Cocoas-Lab/Robocup-SSL-Circuit/MainBoard/Controller.ods

分類 | 値 | パッケージ | 個数 | 単価 | 小計 | 備考 | URL
IC | LM5160QPWPRQ1 | 14-TSSOP | 1 | 628 | 628 |  | https://www.digikey.jp/product-detail/ja/texas-instruments/LM5160QPWPRQ1/296-42408-1-ND/5358045
IC | MCP1700T-33 | SOT-23 | 1 | 46 | 46 |  | https://www.digikey.jp/product-detail/ja/microchip-technology/MCP1700T-3302E-TT/MCP1700T3302ETTCT-ND/652677
IC | ADR5041 | SC-70 | 1 | 114 | 114 |  | https://www.digikey.jp/product-detail/ja/analog-devices-inc/ADR5041AKSZ-REEL7/ADR5041AKSZ-REEL7CT-ND/3830854
IC | FT232RL | 28-SSOP | 1 | 542 | 542 |  | https://www.digikey.jp/product-detail/ja/ftdi-future-technology-devices-international-ltd/FT232RL-TUBE/768-1306-ND/4006920
IC | LPC1549JBD48 | LQFP48 | 1 | 862 | 862 |  | https://www.digikey.jp/products/ja?keywords=LPC1549JBD48
コネクタ | ディーンズヘッダ |  | 7 |  | 0
コネクタ | 53375-0610 |  | 6 |  | 0
コネクタ | UX60SC-MB-5ST | Micro-B | 1 |  | 0
コネクタ | 53375-0410 |  | 1 |  | 0
コネクタ | 2mmピッチピンヘッダ |  | 2 |  | 0
インダクタ | 22uH |  |  |  | 0
フューズ | 15A |  |  |  | 0
フューズ | 10A |  |  |  | 0
抵抗 |  |  |  |  | 0
抵抗 |  |  |  |  | 0
抵抗 |  |  |  |  | 0
抵抗 |  |  |  |  | 0
抵抗 |  |  |  |  | 0
抵抗 |  |  |  |  | 0
抵抗 |  |  |  |  | 0
抵抗 |  |  |  |  | 0
抵抗 |  |  |  |  | 0
抵抗 |  |  |  |  | 0
セラミックコンデンサ |  |  |  |  | 0
セラミックコンデンサ |  |  |  |  | 0
セラミックコンデンサ |  |  |  |  | 0
セラミックコンデンサ |  |  |  |  | 0
セラミックコンデンサ |  |  |  |  | 0
セラミックコンデンサ |  |  |  |  | 0
セラミックコンデンサ |  |  |  |  | 0
セラミックコンデンサ
セラミックコンデンサ |  |  |  |  | 2192
電解コンデンサ
ダイオード
ダイオード
ダイオード
ダイオード
ダイオード
LED
LED
LED
LED
スイッチ
スイッチ
