Cocoas-Lab/Robocup-SSL-Circuit/KickerBoard/Kicker.ods

Sheet: 単体
名称 | 値 | 形状 | 個数 | 単価 | 小計 | URL
抵抗 | 10 | 1608 | 3 | 12 | 36 | https://www.digikey.jp/product-detail/ja/rohm-semiconductor/ESR03EZPJ102/RHM1.0KDCT-ND/1762924
抵抗 | 100 | 1608 | 1 | 12 | 12 | https://www.digikey.jp/product-detail/ja/yageo/RT0603FRE07100RL/YAG2320CT-ND/5252434
抵抗 | 130k | 1005 | 1 | 9 | 9 | https://www.digikey.jp/product-detail/ja/yageo/RC0402JR-07130KL/YAG3273CT-ND/5282139
抵抗 | 1k | 1005 | 2 | 9 | 18 | https://www.digikey.jp/product-detail/ja/yageo/RC0402JR-071KL/311-1.0KJRCT-ND/729355
抵抗 | 2.2k | 4122 | 1 | 56 | 56 | https://www.digikey.jp/product-detail/ja/te-connectivity-passive-product/SMF32K2JT/A131681CT-ND/8603811
抵抗 | 2.2k | 1005 | 2 | 12 | 24 | https://www.digikey.jp/product-detail/ja/yageo/RC0402FR-072K2L/311-2.20KLRCT-ND/729500
抵抗 | 2.4k | 1005 | 1 | 12 | 12 | https://www.digikey.jp/product-detail/ja/yageo/RC0402JR-072K4L/311-2.4KJRCT-ND/729384
抵抗 | 22 | 1608 | 2 | 12 | 24 | https://www.digikey.jp/product-detail/ja/yageo/RC0603JR-0722RL/311-22GRCT-ND/729690
抵抗 | 2.2 | 1608 | 4 | 12 | 48 | https://www.digikey.jp/product-detail/ja/yageo/RC0603JR-072R2L/311-2.2GRCT-ND/729675
抵抗 | 120k | 1005 | 1 | 9 | 9 | https://www.digikey.jp/product-detail/ja/yageo/RC0402JR-07120KL/311-120KJRCT-ND/729368
抵抗 | 2k | 1005 | 1 | 12 | 12 | https://www.digikey.jp/product-detail/ja/yageo/RC0402FR-072KL/311-2KLRCT-ND/2827883
抵抗 | 2m | R4-FC4L | 1 | 238 | 238 | https://www.digikey.jp/product-detail/ja/ohmite/FC4L64R002GER/FC4L64R002GERCT-ND/3476134
抵抗 | 3.3k | 1005 | 2 | 9 | 18 | https://www.digikey.jp/product-detail/ja/yageo/AC0402FR-073K3L/YAG3483CT-ND/6006332
抵抗 | 330 | 1005 | 4 | 12 | 48 | https://www.digikey.jp/product-detail/ja/yageo/RC0402JR-07330RL/311-330JRCT-ND/729412
抵抗 | 33k | 1005 | 4 | 9 | 36 | https://www.digikey.jp/product-detail/ja/yageo/RC0402JR-0733KL/311-33KJRCT-ND/729415
抵抗 | 10k | 1005 | 18 | 1.7 | 30.6 | https://www.digikey.jp/product-detail/ja/yageo/RC0402JR-0710KL/311-10KJRCT-ND/729365
抵抗 | 0.3m | WSL4026 | 1 | 344 | 344 | https://www.digikey.jp/product-detail/ja/vishay-dale/WSL4026L3000FEB/WSLR-.0003CT-ND/2695229
抵抗 | 1.2M | 1005 | 1 | 12 | 12 | https://www.digikey.jp/product-detail/ja/yageo/RC0402JR-071M2L/YAG3282CT-ND/5282148
抵抗 | 1.5M | 1005 | 1 | 9 | 9 | https://www.digikey.jp/product-detail/ja/yageo/RC0402JR-071M5L/311-1.5MJRCT-ND/729360
抵抗 | 750 | 1005 | 1 | 12 | 12 | https://www.digikey.jp/product-detail/ja/yageo/RC0402FR-07750RL/311-750LRCT-ND/2827891
アルミ電解コンデンサ | 220u | D=6.30[mm] | 1 | 101 | 101 | https://www.digikey.jp/product-detail/ja/nichicon/UCV1V221MCL1GS/493-14355-1-ND/5724342
積層セラミックコンデンサ | 0.1u | 1005 | 10 | 11.9 | 119 | https://www.digikey.jp/product-detail/ja/taiyo-yuden/GMK105BJ104KV-F/587-1994-6-ND/1646692
積層セラミックコンデンサ | 0.22u | 1005 | 2 | 12 | 24 | https://www.digikey.jp/product-detail/ja/samsung-electro-mechanics/CL05F224ZO5NNNC/1276-1060-1-ND/3889146
積層セラミックコンデンサ | 0.47n | 1005 | 2 | 12 | 24 | https://www.digikey.jp/product-detail/ja/tdk-corporation/CGA2B2C0G1H471J050BA/445-5604-1-ND/2443644
積層セラミックコンデンサ | 10n | 1005 | 3 | 12 | 36 | https://www.digikey.jp/product-detail/ja/murata-electronics-north-america/GCM155R71H103KA55D/490-4762-1-ND/1641681
積層セラミックコンデンサ | 10p | 1005 | 2 | 12 | 24 | https://www.digikey.jp/product-detail/ja/murata-electronics-north-america/GRM1555C1H100GA01D/490-6187-1-ND/3845387
積層セラミックコンデンサ | 22n | 1005 | 1 | 14 | 14 | https://www.digikey.jp/product-detail/ja/tdk-corporation/CGA2B3X5R1H223M050BB/445-12206-1-ND/3953872
積層セラミックコンデンサ | 4.7u | 1608 | 2 | 50 | 100 | https://www.digikey.jp/product-detail/ja/samsung-electro-mechanics/CL10A475KL8NRNC/1276-6794-1-ND/5961653
積層セラミックコンデンサ | 47n | 3216 | 1 | 42 | 42 | https://www.digikey.jp/product-detail/ja/murata-electronics-north-america/GRM31CR72H473KW09L/490-16312-1-ND/7363294
インダクタ | 15u | 4949 | 1 | 70 | 70 | https://www.digikey.jp/product-detail/ja/taiyo-yuden/NRS5040T150MMGJV/587-6108-1-ND/8573098
インダクタ | 8.2u | 6664 | 1 | 190 | 190 | https://www.digikey.jp/product-detail/ja/bourns-inc/SRP6060FA-8R2M/SRP6060FA-8R2MCT-ND/9351142
フューズ | 15A | 3216 | 1 | 114 | 114 | https://www.digikey.jp/product-detail/ja/littelfuse-inc/0501015.WR/F2919CT-ND/1953081
IC | AD8601 | SOT23-5 | 1 | 138 | 138 | https://www.digikey.jp/product-detail/ja/analog-devices-inc/AD8601WDRTZ-REEL7/AD8601WDRTZ-REEL7CT-ND/2237758
IC | ADCMP350YKSZ | KS_4 | 1 | 129 | 129 | https://www.digikey.jp/product-detail/ja/analog-devices-inc/ADCMP350YKSZ-REEL7/ADCMP350YKSZ-REEL7CT-ND/2467894
IC | ADR5041 | SC70-3 | 1 | 113 | 113 | https://www.digikey.jp/product-detail/ja/analog-devices-inc/ADR5041AKSZ-REEL7/ADR5041AKSZ-REEL7CT-ND/3830854
IC | INA213 | SC70-6 | 1 | 178 | 178 | https://www.digikey.jp/product-detail/ja/texas-instruments/INA213AIDCKR/296-26072-1-ND/2254845
IC | MAX3051ESA+ | SOIC127P600X175-8N | 1 | 391 | 391 | https://www.digikey.jp/product-detail/ja/maxim-integrated/MAX3051ESA-T/MAX3051ESA-CT-ND/5402433
IC | MIC5219-3.3YMM | MSOP-8_MM | 1 | 141 | 141 | https://www.digikey.jp/product-detail/ja/microchip-technology/MIC5219-3.3YMM-TR/MIC5219-3.3YMM-CT-ND/9450540
IC | LT6108-2 | MSOP8 | 1 | 385 | 385 | https://www.digikey.jp/product-detail/ja/linear-technology-analog-devices/LT6108IMS8-2-PBF/LT6108IMS8-2-PBF-ND/2734947
IC | LM5160QPWPRQ1 | SOP65P640X110-15N | 1 | 605 | 605 | https://www.digikey.jp/product-detail/ja/texas-instruments/LM5160QPWPRQ1/296-42408-1-ND/5358045
IC | LPC1549JBD48 | QFP48 | 1 | 864 | 864 | https://www.digikey.jp/products/ja?keywords=LPC1549JBD48
IC | TPD4S014DSQR |  | 1 | 205 | 205 | https://www.digikey.jp/product-detail/ja/texas-instruments/TPD4S014DSQR/296-29093-1-ND/2688396
IC | UCC27212DPRT |  | 1 | 491 | 491 | https://www.digikey.jp/product-detail/ja/texas-instruments/UCC27212DPRT/296-47091-1-ND/7596472
IC | UCC27512DRSR |  | 1 | 173 | 173 | https://www.digikey.jp/product-detail/ja/texas-instruments/UCC27512DRSR/296-34812-1-ND/3523717
IC | UCC27524DGN-NOPAD |  | 1 | 206 | 206 | https://www.digikey.jp/product-detail/ja/texas-instruments/UCC27524DGNR/296-30607-1-ND/3486672
IGBT | IXXH80N65B4 | TO247-3 | 2 | 803 | 1606 | https://www.digikey.jp/product-detail/ja/ixys/IXXH80N65B4/IXXH80N65B4-ND/3908803
FET | AO4444 | SOIC8 | 2 | 211 | 422 | https://www.digikey.jp/product-detail/ja/vishay-siliconix/SI4090DY-T1-GE3/SI4090DY-T1-GE3CT-ND/3458171
FET | BSP130 | SOT23-3 | 1 | 102 | 102 | https://www.digikey.jp/product-detail/ja/nexperia-usa-inc/BSP130115/1727-4928-1-ND/2531507
FET | BSS138 | SOT23-3 | 1 | 38 | 38 | https://www.digikey.jp/product-detail/ja/on-semiconductor/BSS138/BSS138CT-ND/244294
FET | TK12P60W | DPAK-3 | 1 | 385 | 385 | https://www.digikey.jp/product-detail/ja/infineon-technologies/IPD80R280P7ATMA1/IPD80R280P7ATMA1CT-ND/6228209
Transistor | ZXTN08400BFF | SOT23-3 | 1 | 40 | 40 | https://www.digikey.jp/product-detail/ja/on-semiconductor/FJV42MTF/FJV42MTFCT-ND/4553174
ダイオード | US5G-TP | DO214-AB | 1 | 66 | 66 | https://www.digikey.jp/product-detail/ja/micro-commercial-co/US5G-TP/US5G-TPMSCT-ND/8554572
ダイオード | SMAJ300 | DO-214AC | 1 | 68 | 68 | https://www.digikey.jp/product-detail/ja/littelfuse-inc/SMAJ300A/SMAJ300ALFCT-ND/762560
ダイオード | SMAJP4KE30A | DO-214AC | 1 | 60 | 60 | https://www.digikey.jp/product-detail/ja/micro-commercial-co/SMAJP4KE30A-TP/SMAJP4KE30A-TPMSCT-ND/7681713
ダイオード | AS4PG | SMPC | 2 | 89 | 178 | https://www.digikey.jp/product-detail/ja/vishay-semiconductor-diodes-division/AS4PG-M3-86A/AS4PG-M3-86AGICT-ND/2709013
ダイオード | SDM2U40CSP | WLB1608 | 2 | 55 | 110 | https://www.digikey.jp/product-detail/ja/diodes-incorporated/SDM2U40CSP-7B/SDM2U40CSP-7BDICT-ND/6013037
ダイオード | RB520S | SOD523 | 5 | 20.4 | 102 | https://www.digikey.jp/product-detail/ja/on-semiconductor/RB520S30T1G/RB520S30T1GOSCT-ND/964626
LED | 赤 | 1608 | 3 |  | 0
LED | 緑 | 1608 | 1 |  | 0
LED | 白 | 1608 | 1 |  | 0
発振子 | FA238V |  | 1 | 135 | 135 | https://www.digikey.jp/product-detail/ja/epson/FA-238V-12.0000MB-K3/SER3682CT-ND/2403455
コネクタ | 5569-02A2 |  | 2 | 128 | 256 | https://www.digikey.jp/products/ja?keywords=39-30-1021
コネクタ | SM03B-ZESS-TB |  | 1 | 77 | 77 | https://www.digikey.jp/product-detail/ja/jst-sales-america-inc/SM03B-ZESS-TB-LF-SN/455-2396-1-ND/1887049
コネクタ | Micro USB |  | 1 | 98 | 98 | https://www.digikey.jp/product-detail/ja/hirose-electric-co-ltd/ZX62-AB-5PA-31/H125279CT-ND/5994741
スイッチ | SKRP |  | 2 |  | 0
合計 |  |  |  |  | 9627.6

Sheet: 10枚製作時
名称 | 値 | 形状 | 個数 | 単価 | 小計 | URL
抵抗 | 10 | 1608 | 30 | 10.3 | 309 | https://www.digikey.jp/product-detail/ja/rohm-semiconductor/ESR03EZPJ102/RHM1.0KDCT-ND/1762924
抵抗 | 100 | 1608 | 10 | 8.1 | 81 | https://www.digikey.jp/product-detail/ja/yageo/RT0603FRE07100RL/YAG2320CT-ND/5252434
抵抗 | 130k | 1005 | 10 | 1.7 | 17 | https://www.digikey.jp/product-detail/ja/yageo/RC0402JR-07130KL/YAG3273CT-ND/5282139
抵抗 | 1k | 1005 | 20 | 1.7 | 34 | https://www.digikey.jp/product-detail/ja/yageo/RC0402JR-071KL/311-1.0KJRCT-ND/729355
抵抗 | 2.2k | R-S-3 | 10 | 46.7 | 467 | https://www.digikey.jp/product-detail/ja/te-connectivity-passive-product/SMF32K2JT/A131681CT-ND/8603811
抵抗 | 2.2k | 1005 | 20 | 2.1 | 42 | https://www.digikey.jp/product-detail/ja/yageo/RC0402FR-072K2L/311-2.20KLRCT-ND/729500
抵抗 | 2.4k | 1005 | 10 | 1.8 | 18 | https://www.digikey.jp/product-detail/ja/yageo/RC0402JR-072K4L/311-2.4KJRCT-ND/729384
抵抗 | 22 | 1608 | 20 | 2.6 | 52 | https://www.digikey.jp/product-detail/ja/yageo/RC0603JR-0722RL/311-22GRCT-ND/729690
抵抗 | 2.2 | 1608 | 40 | 5.2 | 208 | https://www.digikey.jp/product-detail/ja/yageo/RC0603JR-072R2L/311-2.2GRCT-ND/729675
抵抗 | 120k | 1005 | 10 | 1.7 | 17 | https://www.digikey.jp/product-detail/ja/yageo/RC0402JR-07120KL/311-120KJRCT-ND/729368
抵抗 | 2k | 1005 | 10 | 2.1 | 21 | https://www.digikey.jp/product-detail/ja/yageo/RC0402FR-072KL/311-2KLRCT-ND/2827883
抵抗 | 2m | R4-FC4L | 10 | 210.9 | 2109 | https://www.digikey.jp/product-detail/ja/ohmite/FC4L64R002GER/FC4L64R002GERCT-ND/3476134
抵抗 | 3.3k | 1005 | 20 | 2.8 | 56 | https://www.digikey.jp/product-detail/ja/yageo/AC0402FR-073K3L/YAG3483CT-ND/6006332
抵抗 | 330 | 1005 | 40 | 1.8 | 72 | https://www.digikey.jp/product-detail/ja/yageo/RC0402JR-07330RL/311-330JRCT-ND/729412
抵抗 | 33k | 1005 | 40 | 1.7 | 68 | https://www.digikey.jp/product-detail/ja/yageo/RC0402JR-0733KL/311-33KJRCT-ND/729415
抵抗 | 10k | 1005 | 180 | 0.69 | 124.2 | https://www.digikey.jp/product-detail/ja/yageo/RC0402JR-0710KL/311-10KJRCT-ND/729365
抵抗 | 0.3m | WSL4026 | 10 | 305.1 | 3051 | https://www.digikey.jp/product-detail/ja/vishay-dale/WSL4026L3000FEB/WSLR-.0003CT-ND/2695229
抵抗 | 1.2M | 1005 | 10 | 1.8 | 18 | https://www.digikey.jp/product-detail/ja/yageo/RC0402JR-071M2L/YAG3282CT-ND/5282148
抵抗 | 1.5M | 1005 | 10 | 1.7 | 17 | https://www.digikey.jp/product-detail/ja/yageo/RC0402JR-071M5L/311-1.5MJRCT-ND/729360
抵抗 | 750 | 1005 | 10 | 2.1 | 21 | https://www.digikey.jp/product-detail/ja/yageo/RC0402FR-07750RL/311-750LRCT-ND/2827891
アルミ電解コンデンサ | 22u | D=6.30[mm] | 10 | 76.4 | 764 | https://www.digikey.jp/product-detail/ja/nichicon/UCV1V221MCL1GS/493-14355-1-ND/5724342
積層セラミックコンデンサ | 0.1u | 1005 | 100 | 5.56 | 556 | https://www.digikey.jp/product-detail/ja/taiyo-yuden/GMK105BJ104KV-F/587-1994-6-ND/1646692
積層セラミックコンデンサ | 0.22u | 1005 | 20 | 7.8 | 156 | https://www.digikey.jp/product-detail/ja/samsung-electro-mechanics/CL05F224ZO5NNNC/1276-1060-1-ND/3889146
積層セラミックコンデンサ | 0.47n | 1005 | 20 | 8.1 | 162 | https://www.digikey.jp/product-detail/ja/tdk-corporation/CGA2B2C0G1H471J050BA/445-5604-1-ND/2443644
積層セラミックコンデンサ | 10n | 1005 | 30 | 5.7 | 171 | https://www.digikey.jp/product-detail/ja/murata-electronics-north-america/GCM155R71H103KA55D/490-4762-1-ND/1641681
積層セラミックコンデンサ | 10p | 1005 | 20 | 9 | 180 | https://www.digikey.jp/product-detail/ja/murata-electronics-north-america/GRM1555C1H100GA01D/490-6187-1-ND/3845387
積層セラミックコンデンサ | 22n | 1005 | 10 | 10.8 | 108 | https://www.digikey.jp/product-detail/ja/tdk-corporation/CGA2B3X5R1H223M050BB/445-12206-1-ND/3953872
積層セラミックコンデンサ | 4.7u | 1608 | 20 | 34.9 | 698 | https://www.digikey.jp/product-detail/ja/samsung-electro-mechanics/CL10A475KL8NRNC/1276-6794-1-ND/5961653
積層セラミックコンデンサ | 47n | 3216 | 10 | 28.5 | 285 | https://www.digikey.jp/product-detail/ja/murata-electronics-north-america/GRM31CR72H473KW09L/490-16312-1-ND/7363294
インダクタ | 15u | 4949 | 10 | 60.8 | 608 | https://www.digikey.jp/product-detail/ja/taiyo-yuden/NRS5040T150MMGJV/587-6108-1-ND/8573098
インダクタ | 8.2u | 6664 | 10 | 174.9 | 1749 | https://www.digikey.jp/product-detail/ja/bourns-inc/SRP6060FA-8R2M/SRP6060FA-8R2MCT-ND/9351142
フューズ | 15A | 3216 | 10 | 103.3 | 1033 | https://www.digikey.jp/product-detail/ja/littelfuse-inc/0501015.WR/F2919CT-ND/1953081
IC | AD8601 | SOT23-5 | 10 | 122.5 | 1225 | https://www.digikey.jp/product-detail/ja/analog-devices-inc/AD8601WDRTZ-REEL7/AD8601WDRTZ-REEL7CT-ND/2237758
IC | ADCMP350YKSZ | KS_4 | 10 | 115.3 | 1153 | https://www.digikey.jp/product-detail/ja/analog-devices-inc/ADCMP350YKSZ-REEL7/ADCMP350YKSZ-REEL7CT-ND/2467894
IC | ADR5041 | SC70-3 | 10 | 100.9 | 1009 | https://www.digikey.jp/product-detail/ja/analog-devices-inc/ADR5041AKSZ-REEL7/ADR5041AKSZ-REEL7CT-ND/3830854
IC | INA213 | SC70-6 | 10 | 158.5 | 1585 | https://www.digikey.jp/product-detail/ja/texas-instruments/INA213AIDCKR/296-26072-1-ND/2254845
IC | MAX3051ESA+ | SOIC127P600X175-8N | 10 | 368.9 | 3689 | https://www.digikey.jp/product-detail/ja/maxim-integrated/MAX3051ESA-T/MAX3051ESA-CT-ND/5402433
IC | MIC5219-3.3YMM | MSOP-8_MM | 10 | 141 | 1410 | https://www.digikey.jp/product-detail/ja/microchip-technology/MIC5219-3.3YMM-TR/MIC5219-3.3YMM-CT-ND/9450540
IC | LT6108-2 | MSOP8 | 10 | 385 | 3850 | https://www.digikey.jp/product-detail/ja/linear-technology-analog-devices/LT6108IMS8-2-PBF/LT6108IMS8-2-PBF-ND/2734947
IC | LM5160QPWPRQ1 | SOP65P640X110-15N | 10 | 543.3 | 5433 | https://www.digikey.jp/product-detail/ja/texas-instruments/LM5160QPWPRQ1/296-42408-1-ND/5358045
IC | LPC1549JBD48 | QFP48 | 10 | 780.8 | 7808 | https://www.digikey.jp/products/ja?keywords=LPC1549JBD48
IC | TPD4S014DSQR |  | 10 | 183.1 | 1831 | https://www.digikey.jp/product-detail/ja/texas-instruments/TPD4S014DSQR/296-29093-1-ND/2688396
IC | UCC27212DPRT |  | 10 | 441.2 | 4412 | https://www.digikey.jp/product-detail/ja/texas-instruments/UCC27212DPRT/296-47091-1-ND/7596472
IC | UCC27512DRSR |  | 10 | 155.3 | 1553 | https://www.digikey.jp/product-detail/ja/texas-instruments/UCC27512DRSR/296-34812-1-ND/3523717
IC | UCC27524DGN-NOPAD |  | 10 | 185.1 | 1851 | https://www.digikey.jp/product-detail/ja/texas-instruments/UCC27524DGNR/296-30607-1-ND/3486672
IGBT | IXXH80N65B4 | TO247-3 | 20 | 772.7 | 15454 | https://www.digikey.jp/product-detail/ja/ixys/IXXH80N65B4/IXXH80N65B4-ND/3908803
FET | AO4444 | SOIC8 | 20 | 187.2 | 3744 | https://www.digikey.jp/product-detail/ja/vishay-siliconix/SI4090DY-T1-GE3/SI4090DY-T1-GE3CT-ND/3458171
FET | BSP130 | SOT23-3 | 10 | 90.2 | 902 | https://www.digikey.jp/product-detail/ja/nexperia-usa-inc/BSP130115/1727-4928-1-ND/2531507
FET | BSS138 | SOT23-3 | 10 | 34.6 | 346 | https://www.digikey.jp/product-detail/ja/on-semiconductor/BSS138/BSS138CT-ND/244294
FET | TK12P60W | DPAK-3 | 10 | 334.3 | 3343 | https://www.digikey.jp/product-detail/ja/infineon-technologies/IPD80R280P7ATMA1/IPD80R280P7ATMA1CT-ND/6228209
Transistor | ZXTN08400BFF | SOT23-3 | 10 | 30.4 | 304 | https://www.digikey.jp/product-detail/ja/on-semiconductor/FJV42MTF/FJV42MTFCT-ND/4553174
ダイオード | US5G-TP | DO214-AB | 10 | 52.3 | 523 | https://www.digikey.jp/product-detail/ja/micro-commercial-co/US5G-TP/US5G-TPMSCT-ND/8554572
ダイオード | SMAJ300 | DO-214AC | 10 | 56.9 | 569 | https://www.digikey.jp/product-detail/ja/littelfuse-inc/SMAJ300A/SMAJ300ALFCT-ND/762560
ダイオード | SMAJP4KE30A | DO-214AC | 10 | 42.9 | 429 | https://www.digikey.jp/product-detail/ja/micro-commercial-co/SMAJP4KE30A-TP/SMAJP4KE30A-TPMSCT-ND/7681713
ダイオード | AS4PG | SMPC | 20 | 77.9 | 1558 | https://www.digikey.jp/product-detail/ja/vishay-semiconductor-diodes-division/AS4PG-M3-86A/AS4PG-M3-86AGICT-ND/2709013
ダイオード | SDM2U40CSP | WLB1608 | 20 | 41 | 820 | https://www.digikey.jp/product-detail/ja/diodes-incorporated/SDM2U40CSP-7B/SDM2U40CSP-7BDICT-ND/6013037
ダイオード | RB520S | SOD523 | 50 | 20.4 | 1020 | https://www.digikey.jp/product-detail/ja/on-semiconductor/RB520S30T1G/RB520S30T1GOSCT-ND/964626
LED | 赤 | 1608 | 30 |  | 0
LED | 緑 | 1608 | 10 |  | 0
LED | 白 | 1608 | 10 | 0 | 0
発振子 | FA238V |  | 10 | 120 | 1200 | https://www.digikey.jp/product-detail/ja/epson/FA-238V-12.0000MB-K3/SER3682CT-ND/2403455
コネクタ | 5569-02A2 |  | 20 | 112.9 | 2258 | https://www.digikey.jp/products/ja?keywords=39-30-1021
コネクタ | SM03B-ZESS-TB |  | 10 | 72 | 720 | https://www.digikey.jp/product-detail/ja/jst-sales-america-inc/SM03B-ZESS-TB-LF-SN/455-2396-1-ND/1887049
コネクタ | Micro USB |  | 10 | 86.4 | 864 | https://www.digikey.jp/product-detail/ja/hirose-electric-co-ltd/ZX62-AB-5PA-31/H125279CT-ND/5994741
スイッチ | SKRP |  | 20 |  | 0
合計 |  |  |  |  | 84135.2
基板単価 |  |  |  |  | 8413.52
