Cocoas-Lab/Robocup-SSL-Circuit/MotorDriver/MotorDriver.ods

Sheet: 単体
分類 | 値 | パッケージ | 個数 | 単価 | 小計 | 備考 | URL
IC | LPC1549JBD48 | LQFP48 | 1 | 862 | 862 |  | https://www.digikey.jp/products/ja?keywords=LPC1549JBD48
IC | DRV8320SRTVT | WQFN32 | 1 | 482 | 482 |  | https://www.digikey.jp/product-detail/ja/texas-instruments/DRV8320SRTVT/296-47007-1-ND/7427014
IC | MCP1700T-33 | SOT-23 | 1 | 46 | 46 |  | https://www.digikey.jp/product-detail/ja/microchip-technology/MCP1700T-3302E-TT/MCP1700T3302ETTCT-ND/652677
IC | ADR5041 | SC-70 | 1 | 114 | 114 |  | https://www.digikey.jp/product-detail/ja/analog-devices-inc/ADR5041AKSZ-REEL7/ADR5041AKSZ-REEL7CT-ND/3830854
IC | ADCMP350 | SC-70 | 1 | 128 | 128 |  | https://www.digikey.jp/product-detail/ja/analog-devices-inc/ADCMP350YKSZ-REEL7/ADCMP350YKSZ-REEL7CT-ND/2467894
IC | MAX3051ESA | SOIC-8 | 1 | 389 | 389 |  | https://www.digikey.jp/product-detail/ja/maxim-integrated/MAX3051ESA-T/MAX3051ESA-CT-ND/5402433
IC | TPD4S014DSQR | WFDFN-10 | 1 | 204 | 204 |  | https://www.digikey.jp/product-detail/ja/texas-instruments/TPD4S014DSQR/296-29093-1-ND/2688396
IC | AS5601 | SOIC-8 | 1 | 615 | 615 |  | https://www.digikey.jp/product-detail/ja/ams/AS5601-ASOM/AS5601-ASOMCT-ND/5032390
抵抗 | 10 | 1608 | 6 | 12 | 72 |  | https://www.digikey.jp/product-detail/ja/rohm-semiconductor/ESR03EZPJ102/RHM1.0KDCT-ND/1762924
抵抗 | 330 | 1005 | 5 | 12 | 60 |  | https://www.digikey.jp/product-detail/ja/yageo/RC0603FR-07100RL/311-330HRCT-ND/
抵抗 | 2.2k | 1005 | 6 |  | 0 |  | https://www.digikey.jp/product-detail/ja/te-connectivity-passive-product/CRGCQ0402J2K2/A130050CT-ND/8577882
抵抗 | 10k | 1005 | 5 | 12 | 60 |  | https://www.digikey.jp/product-detail/ja/yageo/RC0603JR-0710KL/311-10KGRCT-ND/729647
抵抗 | 12k | 1005 | 1 |  | 0 |  | https://www.digikey.jp/product-detail/ja/stackpole-electronics-inc/RMCF0402JT12K0/RMCF0402JT12K0CT-ND/2417827
抵抗 | 22k | 1005 | 1 |  | 0 |  | https://www.digikey.jp/product-detail/ja/te-connectivity-passive-product/CRGCQ0402J22K/A130056CT-ND/8577888
抵抗 | 33k | 1005 | 1 |  | 0 |  | https://www.digikey.jp/product-detail/ja/te-connectivity-passive-product/CRGCQ0402J33K/A130057CT-ND/8577889
抵抗 | 100k | 1005 | 1 |  | 0 |  | https://www.digikey.jp/product-detail/ja/te-connectivity-passive-product/CRGCQ0402J100K/A130060CT-ND/8577892
セラミックコンデンサ | 10p | 1005 | 2 |  | 0 |  | https://www.digikey.jp/product-detail/ja/kemet/C0402C100K5GACTU/399-7747-1-ND/3471470
セラミックコンデンサ | 47n | 1005 | 3 | 12 | 36 |  | https://www.digikey.jp/product-detail/ja/yageo/CC0402KRX7R9BB473/311-3815-1-ND/8024904
セラミックコンデンサ | 0.1u | 1005 | 8 | 17 | 136 |  | https://www.digikey.jp/product-detail/ja/tdk-corporation/CGA3E3X7S2A104K080AB/445-6938-1-ND/2672956
セラミックコンデンサ | 1u | 1005 | 2 | 56 | 112 |  | https://www.digikey.jp/product-detail/ja/tdk-corporation/CGB2A1JB1E105M033BC/445-12016-1-ND/3953682
セラミックコンデンサ | 10u | 3225 | 13 | 83 | 1079 | 将来的に22[uF]。 実装数を減らしてもいいかも | https://www.digikey.jp/product-detail/ja/kemet/C1210C106M6PACTU/399-5509-1-ND/1950687
インダクタ | 33u | 5050 | 1 |  |  |  | https://www.digikey.jp/product-detail/ja/taiyo-yuden/NR5040T330M/587-2370-1-ND/2178983
ヒューズ | 20A | 3216 | 1 | 145 |  |  | https://www.digikey.jp/product-detail/ja/eaton/TR-3216FF20-R/283-2794-1-ND/1473436
発振子 | 12MHz | SMD | 1 |  |  |  | https://www.digikey.jp/product-detail/ja/epson/FA-238V-12.0000MB-K3/SER3682CT-ND/2403455
FET | BUK7Y3R5-40E | SOT-669 | 6 | 125 | 750 |  | https://www.digikey.jp/product-detail/ja/nexperia-usa-inc/BUK7Y3R5-40HX/1727-7477-1-ND/7897323
ダイオード | SK34ATR | DO-214AC | 6 | 55 | 330 | フリーホイール。 FETのボディダイオードだけでいいかも？ | https://www.digikey.jp/product-detail/ja/smc-diode-solutions/SK34ATR/1655-1591-1-ND/6023036
ダイオード | RB520S30T1G | SOD-523 | 3 | 25 | 75 |  | https://www.digikey.jp/product-detail/ja/on-semiconductor/RB520S30T1G/RB520S30T1GOSCT-ND/964626
ダイオード | SDM2U40CSP |  | 3 |  |  |  | https://www.digikey.jp/product-detail/ja/diodes-incorporated/SDM2U40CSP-7B/SDM2U40CSP-7BDICT-ND/6013037
ダイオード | SMAJP4KE30A | DO-214AC | 1 |  |  |  | https://www.digikey.jp/product-detail/ja/micro-commercial-co/SMAJP4KE30A-TP/SMAJP4KE30A-TPMSCT-ND/7681713
ダイオード | TSPB20U80S S1G | TO-277 | 1 |  |  |  | https://www.digikey.jp/product-detail/ja/taiwan-semiconductor-corporation/TSPB20U80S-S1G/TSPB20U80SS1GCT-ND/7360696
LED | 赤 | 1608 | 3 | 45 | 135 |  | https://www.digikey.jp/product-detail/ja/osram-opto-semiconductors-inc/LS-Q976-NR-1/475-2512-1-ND/1802639
LED | 白 | 1608 | 1 | 58 | 58 |  | https://www.digikey.jp/product-detail/ja/osram-opto-semiconductors-inc/LW-Q38E-Q1OO-3K6L-1/475-2831-1-ND/2176369
LED | 青 | 1608 | 1 | 58 | 58 |  | https://www.digikey.jp/product-detail/ja/osram-opto-semiconductors-inc/LB-Q39G-L2OO-35-1/475-2816-1-ND/2176355
コネクタ | SM03B-ZESS-TB(LF)(SN) |  | 1 | 77 | 77 |  | https://www.digikey.jp/product-detail/ja/jst-sales-america-inc/SM03B-ZESS-TB-LF-SN/455-2396-1-ND/1887049
コネクタ | 43045-0800 |  | 1 | 247 | 247 |  | https://www.digikey.jp/products/ja?keywords=43045-0800
コネクタ | USB-micro typeB |  | 1 |  |  |  | https://www.digikey.jp/product-detail/ja/hirose-electric-co-ltd/ZX62-AB-5PA-31/H125279CT-ND/5994741
コネクタ | XT60 |  | 1 |  |  | どこで買おう 横付けのタイプがあればうれしい
スイッチ | SKRPACE010 |  | 2 | 20 | 40 | 5個で100円のパック | http://akizukidenshi.com/catalog/g/gP-06185/
合計 |  |  |  |  | 6165

Sheet: 20枚製作時
分類 | 値 | パッケージ | 個数 | 単価 | 小計 | 備考 | URL
IC | LPC1549JBD48 | LQFP48 | 20 | 775.9 | 15518 |  | https://www.digikey.jp/products/ja?keywords=LPC1549JBD48
IC | DRV8320SRTVT | WQFN32 | 20 | 430.7 | 8614 |  | https://www.digikey.jp/product-detail/ja/texas-instruments/DRV8320SRTVT/296-47007-1-ND/7427014
IC | MCP1700T-33 | SOT-23 | 20 | 37.6 | 752 |  | https://www.digikey.jp/product-detail/ja/microchip-technology/MCP1700T-3302E-TT/MCP1700T3302ETTCT-ND/652677
IC | ADR5041 | SC-70 | 20 | 100.3 | 2006 |  | https://www.digikey.jp/product-detail/ja/analog-devices-inc/ADR5041AKSZ-REEL7/ADR5041AKSZ-REEL7CT-ND/3830854
IC | ADCMP350 | SC-70 | 20 | 114.5 | 2290 |  | https://www.digikey.jp/product-detail/ja/analog-devices-inc/ADCMP350YKSZ-REEL7/ADCMP350YKSZ-REEL7CT-ND/2467894
IC | MAX3051ESA | SOIC-8 | 20 | 366.6 | 7332 |  | https://www.digikey.jp/product-detail/ja/maxim-integrated/MAX3051ESA-T/MAX3051ESA-CT-ND/5402433
IC | TPD4S014DSQR | WFDFN-10 | 20 | 181.9 | 3638 |  | https://www.digikey.jp/product-detail/ja/texas-instruments/TPD4S014DSQR/296-29093-1-ND/2688396
IC | AS5601 | SOIC-8 | 20 | 479.8 | 9596 |  | https://www.digikey.jp/product-detail/ja/ams/AS5601-ASOM/AS5601-ASOMCT-ND/5032390
抵抗 | 10 | 1608 | 120 | 3.92 | 470.4 |  | https://www.digikey.jp/product-detail/ja/rohm-semiconductor/ESR03EZPJ102/RHM1.0KDCT-ND/1762924
抵抗 | 330 | 1005 | 100 | 1.26 | 126 |  | https://www.digikey.jp/product-detail/ja/yageo/RC0603FR-07100RL/311-330HRCT-ND/
抵抗 | 2.2k | 1005 | 120 | 0.51 | 61.2 |  | https://www.digikey.jp/product-detail/ja/te-connectivity-passive-product/CRGCQ0402J2K2/A130050CT-ND/8577882
抵抗 | 10k | 1005 | 100 | 1.04 | 104 |  | https://www.digikey.jp/product-detail/ja/yageo/RC0603JR-0710KL/311-10KGRCT-ND/729647
抵抗 | 12k | 1005 | 20 | 1.5 | 30 |  | https://www.digikey.jp/product-detail/ja/stackpole-electronics-inc/RMCF0402JT12K0/RMCF0402JT12K0CT-ND/2417827
抵抗 | 22k | 1005 | 20 | 1.3 | 26 |  | https://www.digikey.jp/product-detail/ja/te-connectivity-passive-product/CRGCQ0402J22K/A130056CT-ND/8577888
抵抗 | 33k | 1005 | 20 | 1.3 | 26 |  | https://www.digikey.jp/product-detail/ja/te-connectivity-passive-product/CRGCQ0402J33K/A130057CT-ND/8577889
抵抗 | 100k | 1005 | 20 | 1.3 | 26 |  | https://www.digikey.jp/product-detail/ja/te-connectivity-passive-product/CRGCQ0402J100K/A130060CT-ND/8577892
セラミックコンデンサ | 10p | 1005 | 40 | 2.5 | 100 |  | https://www.digikey.jp/product-detail/ja/kemet/C0402C100K5GACTU/399-7747-1-ND/3471470
セラミックコンデンサ | 47n | 1005 | 60 | 9 | 540 |  | https://www.digikey.jp/product-detail/ja/yageo/CC0402KRX7R9BB473/311-3815-1-ND/8024904
セラミックコンデンサ | 0.1u | 1005 | 160 | 9.27 | 1483.2 |  | https://www.digikey.jp/product-detail/ja/tdk-corporation/CGA3E3X7S2A104K080AB/445-6938-1-ND/2672956
セラミックコンデンサ | 1u | 1005 | 40 | 20.4 | 816 |  | https://www.digikey.jp/product-detail/ja/tdk-corporation/CGB2A1JB1E105M033BC/445-12016-1-ND/3953682
セラミックコンデンサ | 10u | 3225 | 260 | 56.91 | 14796.6 | 将来的に22[uF]。 実装数を減らしてもいいかも | https://www.digikey.jp/product-detail/ja/kemet/C1210C106M6PACTU/399-5509-1-ND/1950687
インダクタ | 33u | 5050 | 20 | 46 | 920 |  | https://www.digikey.jp/product-detail/ja/taiyo-yuden/NR5040T330M/587-2370-1-ND/2178983
ヒューズ | 20A | 3216 | 20 | 131 | 2620 |  | https://www.digikey.jp/product-detail/ja/eaton/TR-3216FF20-R/283-2794-1-ND/1473436
発振子 | 12MHz | SMD | 20 | 119.2 | 2384 |  | https://www.digikey.jp/product-detail/ja/epson/FA-238V-12.0000MB-K3/SER3682CT-ND/2403455
FET | BUK7Y3R5-40E | SOT-669 | 120 | 91.31 | 10957.2 |  | https://www.digikey.jp/product-detail/ja/nexperia-usa-inc/BUK7Y3R5-40HX/1727-7477-1-ND/7897323
ダイオード | SK34ATR | DO-214AC | 120 | 23.44 | 2812.8 | フリーホイール。 FETのボディダイオードだけでいいかも？ | https://www.digikey.jp/product-detail/ja/smc-diode-solutions/SK34ATR/1655-1591-1-ND/6023036
ダイオード | RB520S30T1G | SOD-523 | 60 | 20.3 | 1218 |  | https://www.digikey.jp/product-detail/ja/on-semiconductor/RB520S30T1G/RB520S30T1GOSCT-ND/964626
ダイオード | SDM2U40CSP |  | 60 | 40.8 | 2448 |  | https://www.digikey.jp/product-detail/ja/diodes-incorporated/SDM2U40CSP-7B/SDM2U40CSP-7BDICT-ND/6013037
ダイオード | SMAJP4KE30A | DO-214AC | 20 | 42.7 | 854 |  | https://www.digikey.jp/product-detail/ja/micro-commercial-co/SMAJP4KE30A-TP/SMAJP4KE30A-TPMSCT-ND/7681713
ダイオード | TSPB20U80S S1G | TO-277 | 20 | 110.6 | 2212 |  | https://www.digikey.jp/product-detail/ja/taiwan-semiconductor-corporation/TSPB20U80S-S1G/TSPB20U80SS1GCT-ND/7360696
LED | 赤 | 1608 | 60 | 23.8 | 1428 |  | https://www.digikey.jp/product-detail/ja/osram-opto-semiconductors-inc/LS-Q976-NR-1/475-2512-1-ND/1802639
LED | 白 | 1608 | 20 | 41.7 | 834 |  | https://www.digikey.jp/product-detail/ja/osram-opto-semiconductors-inc/LW-Q38E-Q1OO-3K6L-1/475-2831-1-ND/2176369
LED | 青 | 1608 | 20 | 40.9 | 818 |  | https://www.digikey.jp/product-detail/ja/osram-opto-semiconductors-inc/LB-Q39G-L2OO-35-1/475-2816-1-ND/2176355
コネクタ | SM03B-ZESS-TB(LF)(SN) |  | 20 | 71.5 | 1430 |  | https://www.digikey.jp/product-detail/ja/jst-sales-america-inc/SM03B-ZESS-TB-LF-SN/455-2396-1-ND/1887049
コネクタ | 43045-0800 |  | 20 | 223.4 | 4468 |  | https://www.digikey.jp/products/ja?keywords=43045-0800
コネクタ | USB-micro typeB |  | 20 | 85.9 | 1718 |  | https://www.digikey.jp/product-detail/ja/hirose-electric-co-ltd/ZX62-AB-5PA-31/H125279CT-ND/5994741
コネクタ | XT60 |  | 20 |  | 0 | どこで買おう 横付けのタイプがあればうれしい
スイッチ | SKRPACE010 |  | 40 | 20 | 800 | 5個で100円のパック | http://akizukidenshi.com/catalog/g/gP-06185/
合計 |  |  |  |  | 106273.4
