Cocoas-Lab/Robocup-SSL-Circuit/MotorDriver/MotorDriver.pdf

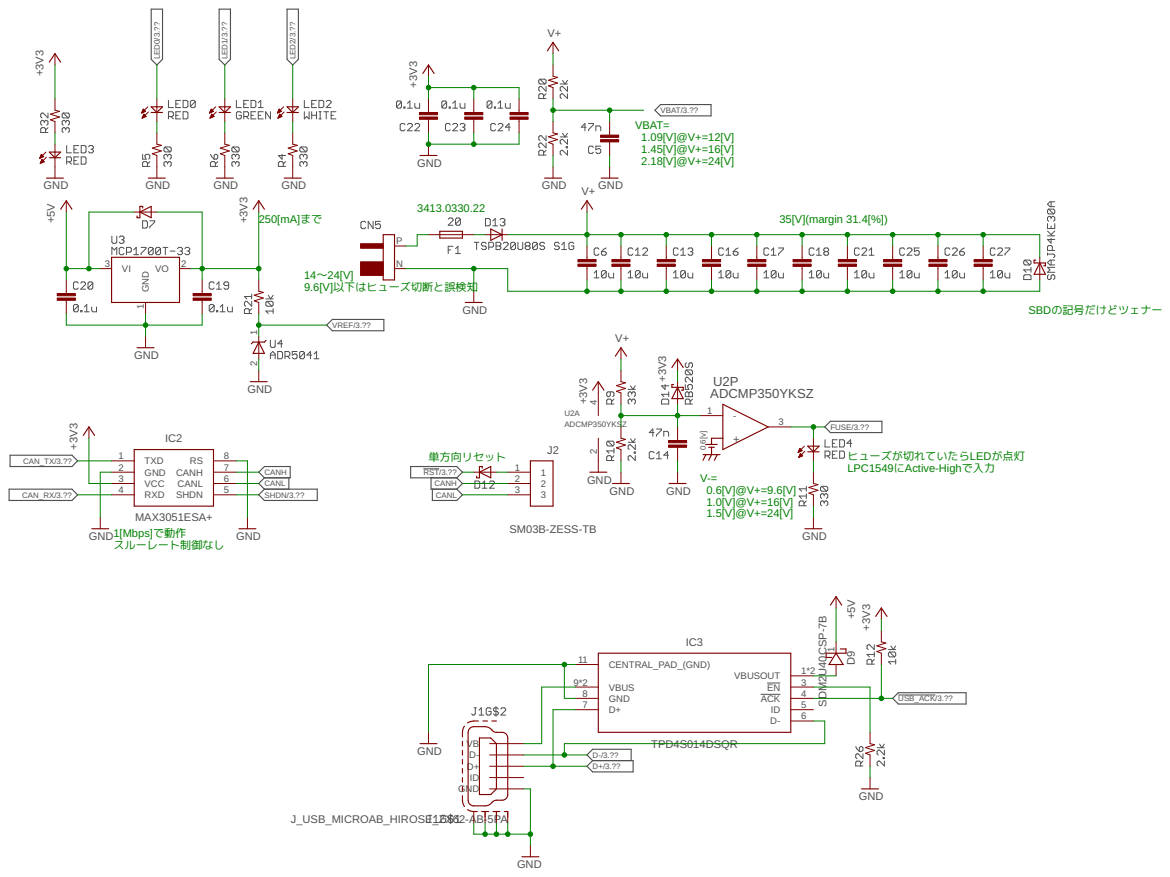
[picture p1: page 1]

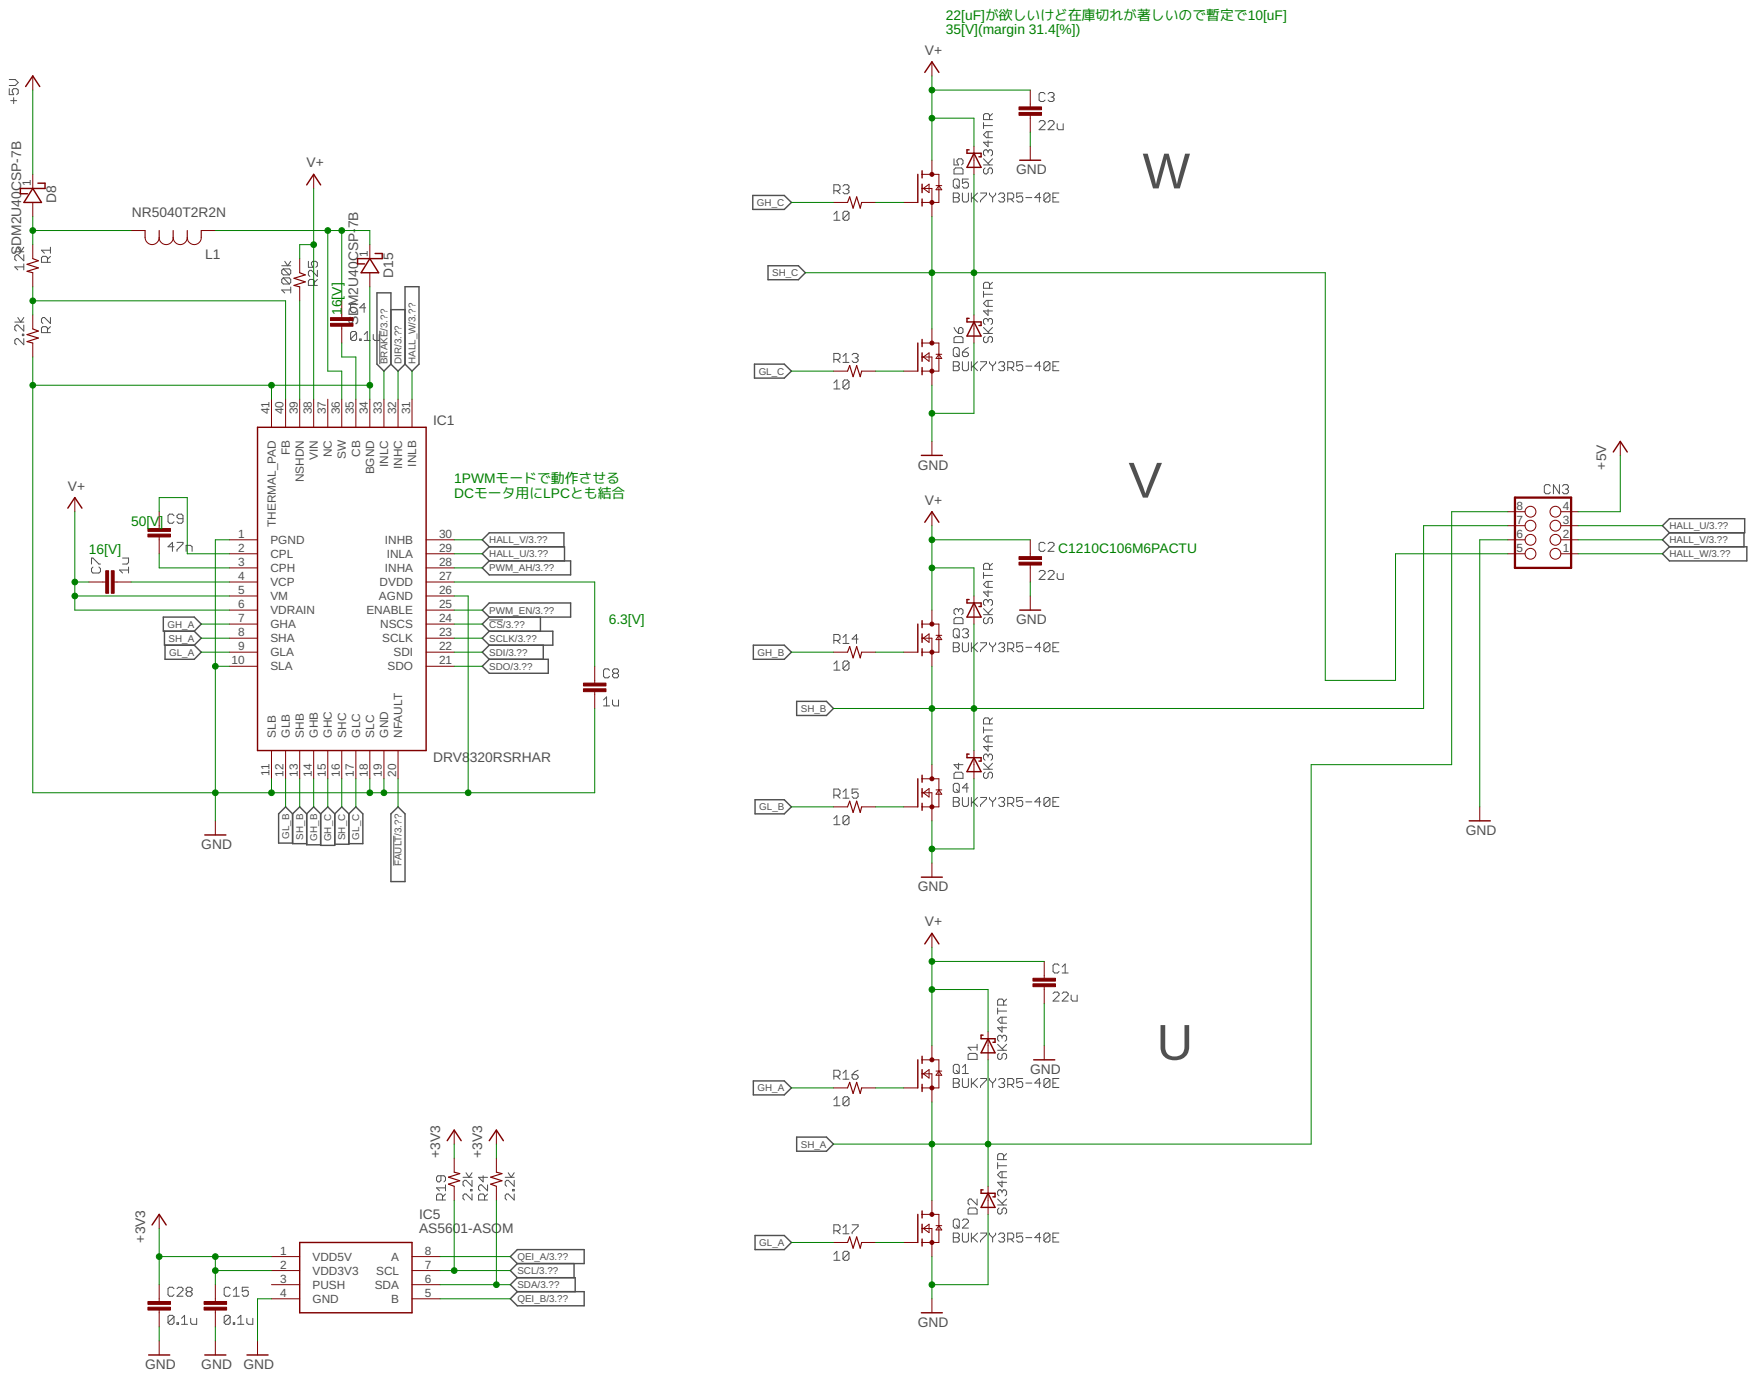
[picture p2: page 2]

SDO/3.?? SDI/3.?? SCLK/3.?? CS/3.?? PWM_EN/3.??

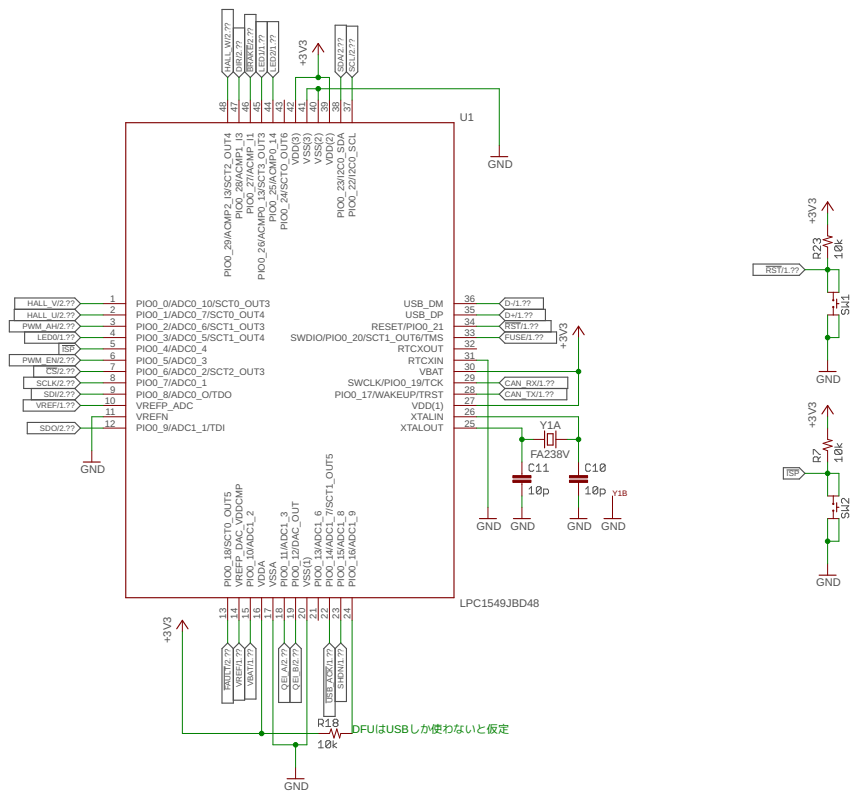
[picture p3: page 3]

+3V3 GND +3V3 LPC1549JBD48 GND GND +3V3 +3V3 GNDGND GND FA238V GND +3V3 GND GND PIO0_0/ADC0_10/SCT0_OUT3 1 PIO0_1/ADC0_7/SCT0_OUT4 2 PIO0_2/ADC0_6/SCT1_OUT3 3 PIO0_3/ADC0_5/SCT1_OUT4 4 PIO0_4/ADC0_4 5 PIO0_5/ADC0_3 6 PIO0_6/ADC0_2/SCT2_OUT3 7 PIO0_7/ADC0_1 8 PIO0_8/ADC0_O/TDO 9 PIO0_9/ADC1_1/TDI 12 PIO0_10/ADC1_2 15 PIO0_11/ADC1_3 18 PIO0_12/DAC_OUT 19 PIO0_13/ADC1_6 21 PIO0_14/ADC1_7/SCT1_OUT5 22 PIO0_15/ADC1_8 23 PIO0_16/ADC1_9 24 PIO0_17/WAKEUP/TRST 28 PIO0_18/SCT0_OUT5 13 PIO0_22/I2C0_SCL 37 PIO0_23/I2C0_SDA 38 PIO0_24/SCTO_OUT6 43 PIO0_25/ACMP0_14 44 PIO0_26/ACMP0_13/SCT3_OUT3 45 PIO0_27/ACMP_I1 46 PIO0_28/ACMP1_I3 47 PIO0_29/ACMP2_I3/SCT2_OUT4 48 RESET/PIO0_21 34 RTCXIN 31 RTCXOUT 32 SWCLK/PIO0_19/TCK 29 SWDIO/PIO0_20/SCT1_OUT6/TMS 33 USB_DM 36 USB_DP 35 VBAT 30 VDD(1) 27 VDD(2) 39 VDD(3) 42 VDDA 16 VREFN 11 VREFP_ADC 10 VREFP_DAC_VDDCMP 14 VSS(1) 20 VSS(2) 40 VSS(3) 41 VSSA 17 XTALIN 26 XTALOUT 25 U1 Y1A RST/1.?? RST/1.?? VREF/1.?? VREF/1.?? ISP ISP D-/1.?? D+/1.?? PWM_AH/2.?? HALL_U/2.?? HALL_V/2.?? HALL_W/2.?? DIR/2.?? BRAKE/2.?? PWM_EN/2.?? CS/2.?? SCLK/2.?? SDI/2.?? SDO/2.?? FAULT/2.?? CAN_TX/1.?? CAN_RX/1.?? LED0/1.?? LED1/1.?? LED2/1.?? VBAT/1.?? SHDN/1.?? QEI_A/2.?? QEI_B/2.?? FUSE/1.?? USB_ACK/1.?? SDA/2.?? SCL/2.?? Y1B DFUはUSBしか使わないと仮定
