Cocoas-Lab/Robocup-SSL-Circuit/KickerBoard/KickerBoard.pdf

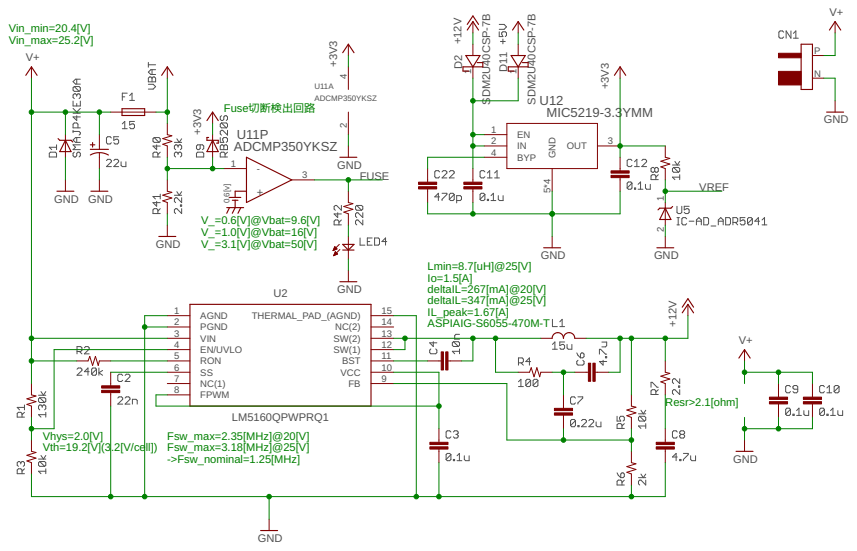
[picture p4: page 1]

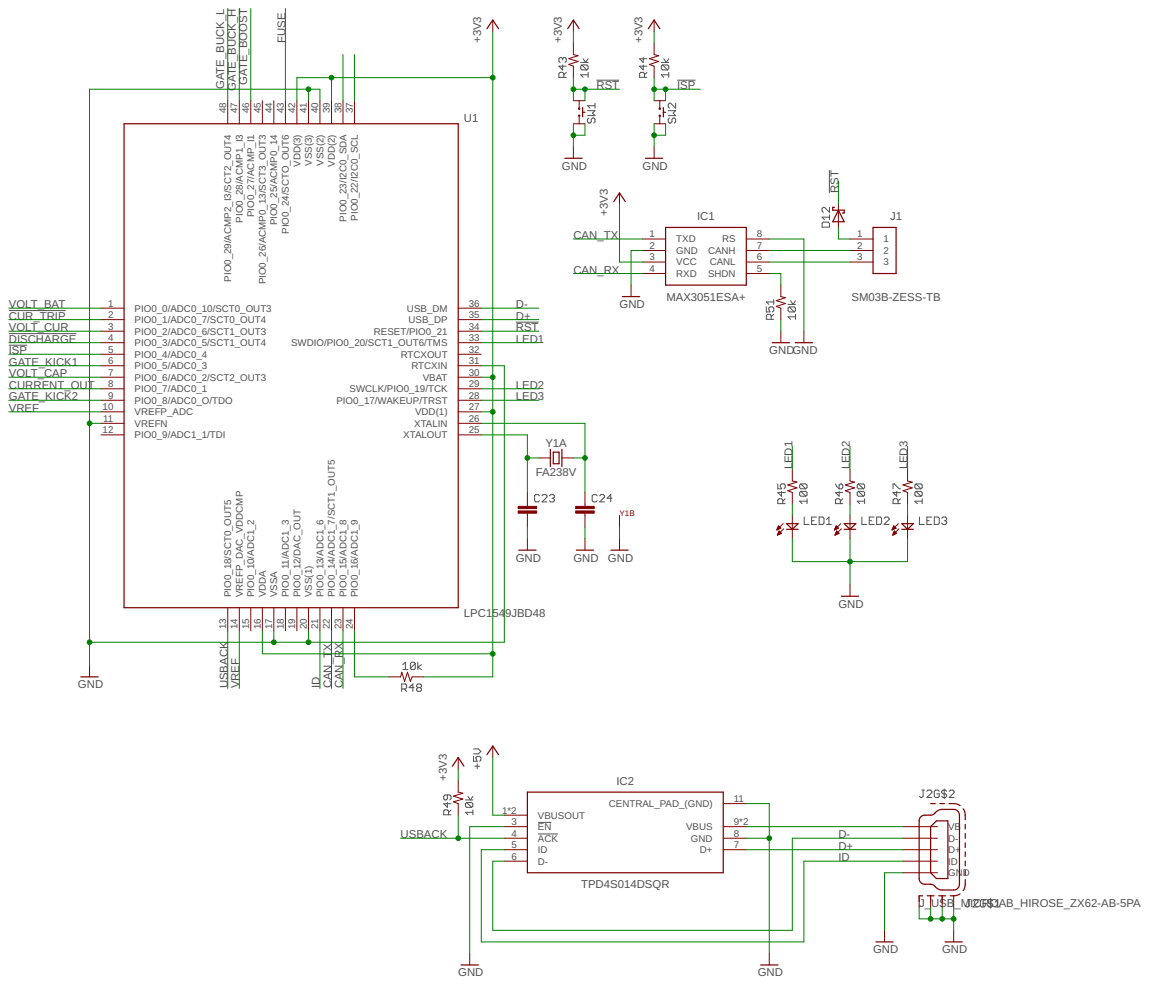
[picture p5: page 2]

14 VSS(1) 20 VSS(2) 40 VSS(3) 41 VSSA

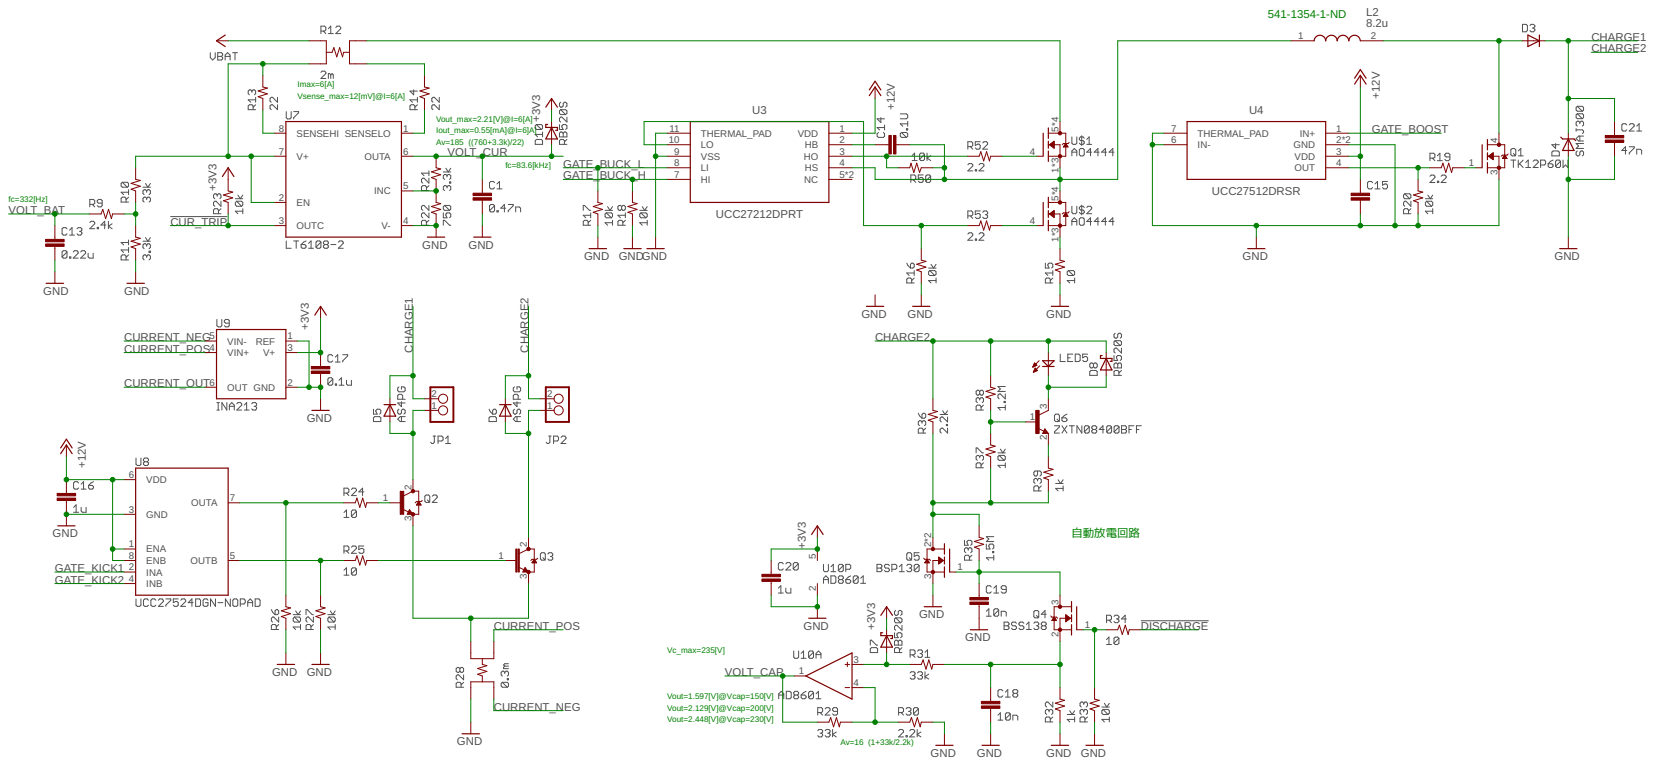
[picture p6: page 3]

Av=16 (1+33k/2.2k) Vout=2.129[V]@Vcap=200[V] Vout=1.597[V]@Vcap=150[V] Vout=2.448[V]@Vcap=230[V]
