Cocoas-Lab/Robocup-SSL-Circuit/MainBoard/MainBoard.brd

## EAGLE design MainBoard/MainBoard.brd (2019-12-03)

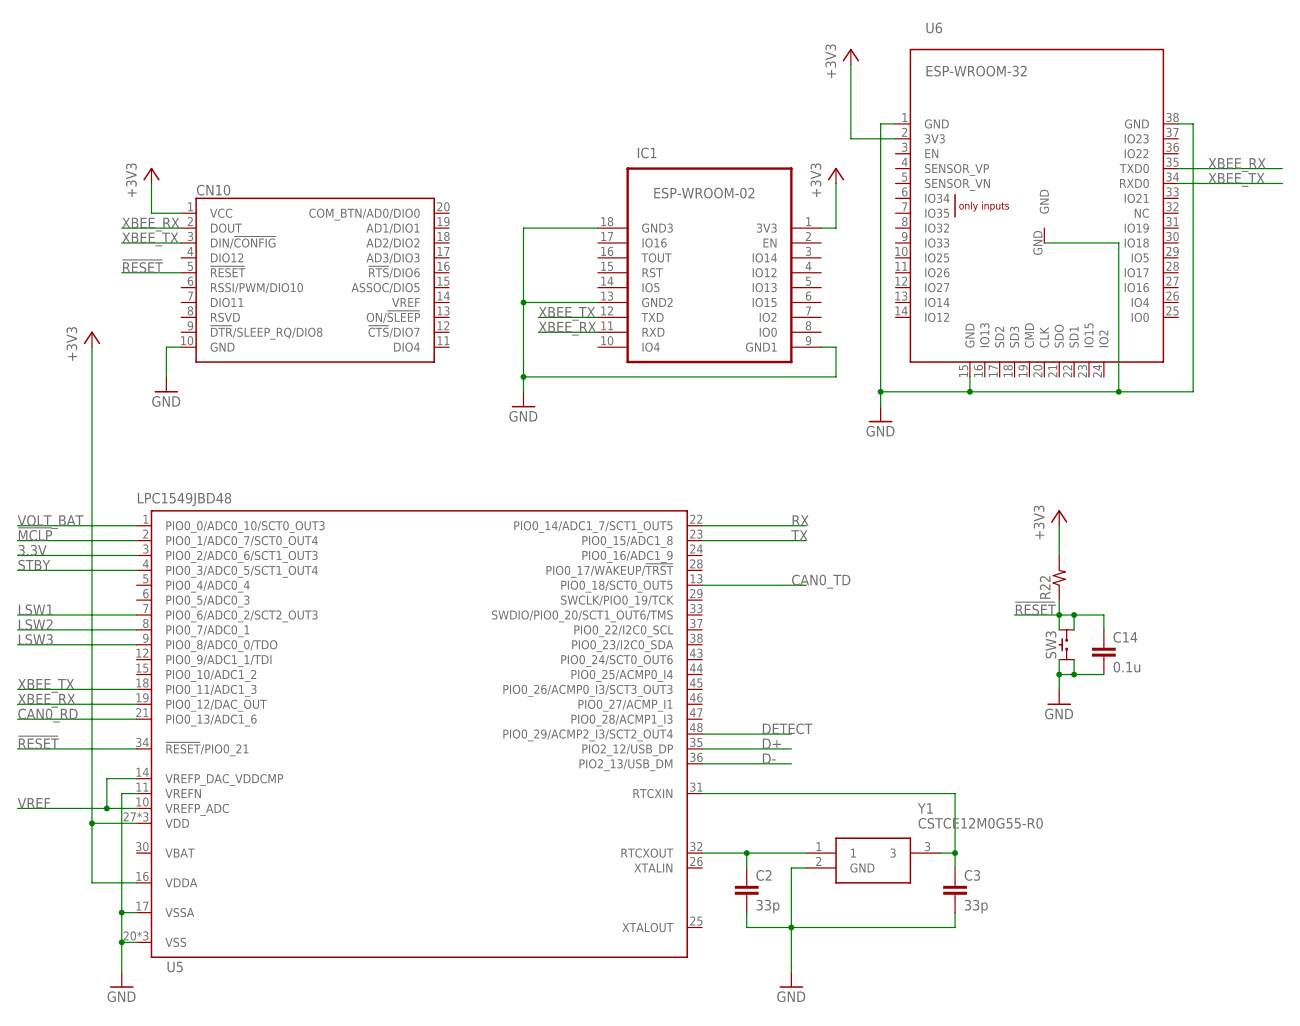
[picture p12: schematic MainBoard.sch, sheet 1, <b>Logic</b>]

Parts:
C2, C3: 33p; C1608
C14: 0.1u; C1608
CN10: XBEE-TH
IC1: ESP-WROOM-02
R22: R1608
SW3: SKRP
U5: LPC1549JBD48; SOT313-2
U6: ESP-WROOM-32
Y1: CSTCE12M0G55-R0

Connections:
3.3V: U5.3 (PIO0_2/ADC0_6/SCT1_OUT3)
!MCLP: U5.2 (PIO0_1/ADC0_7/SCT0_OUT4); also elsewhere on the board
!RESET: C14.1, CN10.5 (!RESET), R22.1, SW3.B1, SW3.B2, U5.34 (!RESET!/PIO0_21)
+3V3: CN10.1 (VCC), IC1.1 (3V3), R22.2, U5.16 (VDDA), U5.27 (VDD), U5.39 (VDD), U5.42 (VDD), U6.2 (3V3); also elsewhere on the board
CAN0_RD: U5.21 (PIO0_13/ADC1_6); also elsewhere on the board
CAN0_TD: U5.13 (PIO0_18/SCT0_OUT5); also elsewhere on the board
D+: U5.35 (PIO2_12/USB_DP); also elsewhere on the board
D-: U5.36 (PIO2_13/USB_DM); also elsewhere on the board
DETECT: U5.48 (PIO0_29/ACMP2_I3/SCT2_OUT4); also elsewhere on the board
GND: C2.2, C3.2, C14.2, CN10.10 (GND), IC1.8 (IO0), IC1.9 (GND1), IC1.13 (GND2), IC1.18 (GND3), IC1.19 (GND0), SW3.A1, SW3.A2, U5.11 (VREFN), U5.17 (VSSA), U5.20 (VSS), U5.40 (VSS), U5.41 (VSS), U6.1 (GND), U6.15 (GND), U6.38 (GND), U6.GND, Y1.2 (GND); also elsewhere on the board
LSW1: U5.7 (PIO0_6/ADC0_2/SCT2_OUT3); also elsewhere on the board
LSW2: U5.8 (PIO0_7/ADC0_1); also elsewhere on the board
LSW3: U5.9 (PIO0_8/ADC0_0/TDO); also elsewhere on the board
unnamed: C2.1, U5.32 (RTCXOUT), Y1.1
unnamed: C3.1, U5.31 (RTCXIN), Y1.3
RX: U5.22 (PIO0_14/ADC1_7/SCT1_OUT5)
STBY: U5.4 (PIO0_3/ADC0_5/SCT1_OUT4); also elsewhere on the board
TX: U5.23 (PIO0_15/ADC1_8)
VBAT: U5.30 (VBAT)
VOLT_BAT: U5.1 (PIO0_0/ADC0_10/SCT0_OUT3); also elsewhere on the board
VREF: U5.10 (VREFP_ADC), U5.14 (VREFP_DAC_VDDCMP); also elsewhere on the board
XBEE_RX: CN10.2 (DOUT), IC1.11 (RXD), U5.19 (PIO0_12/DAC_OUT), U6.35 (TXD0)
XBEE_TX: CN10.3 (DIN/!CONFIG), IC1.12 (TXD), U5.18 (PIO0_11/ADC1_3), U6.34 (RXD0)

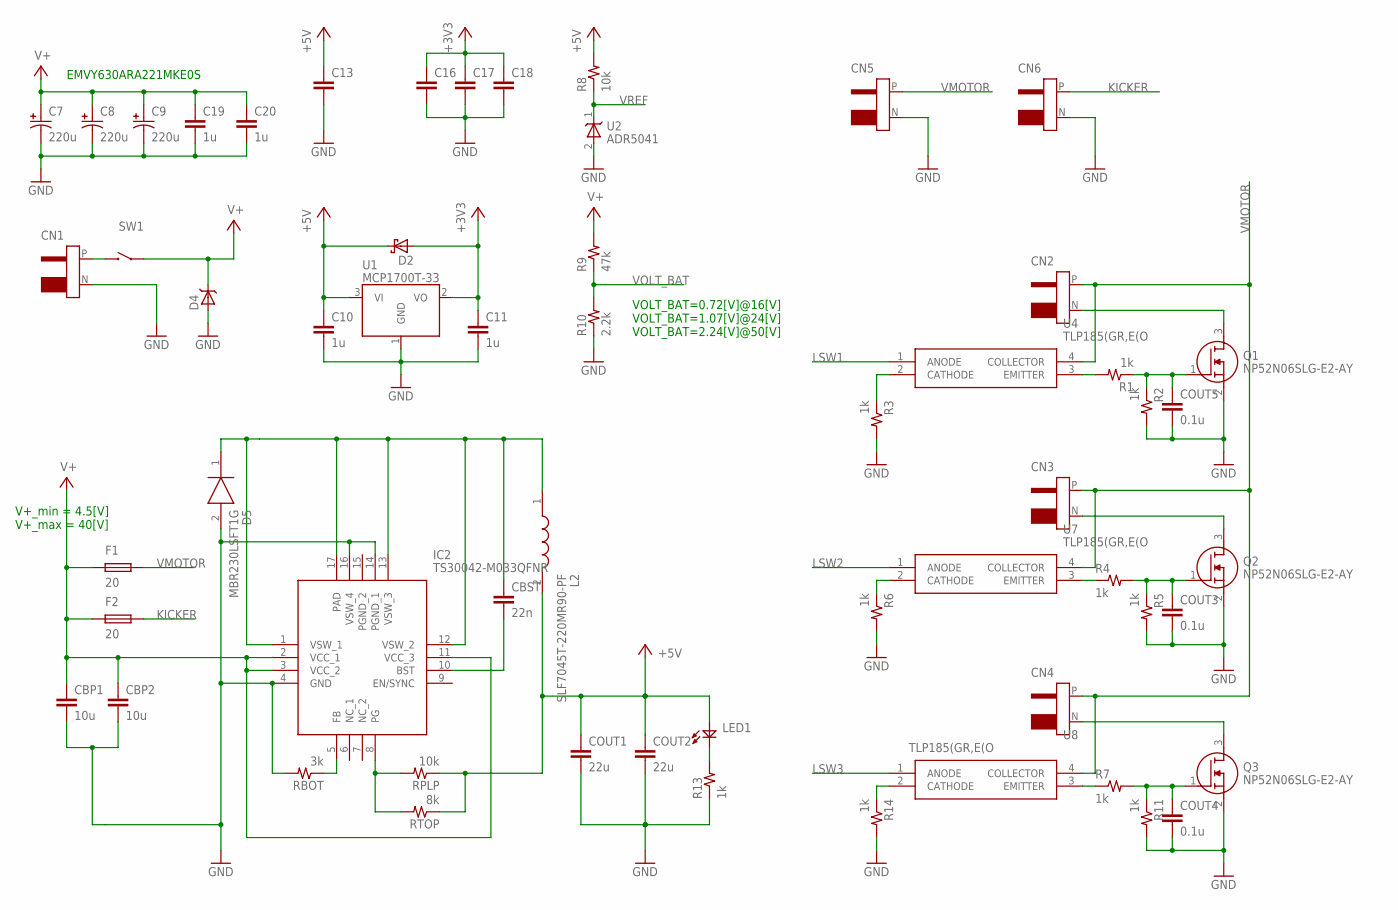
[picture p13: schematic MainBoard.sch, sheet 2, <b>Power</b>]

Parts:
C7, C8, C9: 220u; ES-12.5
C10, C11: 1u; C1608
C13, C16, C17, C18: C1608
C19, C20: 1u; C2012
CBP1, CBP2: 10u; C1608
CBST: 22n; C1608
CN1, CN2, CN3, CN4, CN5, CN6: T-CON
COUT1, COUT2: 22u; C1608
COUT3, COUT4, COUT5: 0.1u; C1608
D2: SBD-1608; DIODE_1608
D4: ZENER-DO-214AC; DO-214AC
D5: MBR230LSFT1G; SODFL3616X98N
F1, F2: 20; 3216
IC2: TS30042-M033QFNR; QFN50P300X300X100-17N
L2: SLF7045T-220MR90-PF; INDPM7070X480N
LED1: LED1608
Q1, Q2, Q3: NP52N06SLG-E2-AY; NP52N06SLGE2AY
R1, R2, R3, R4, R5, R6, R7, R11, R13, R14: 1k; R1608
R8: 10k; R1608
R9: 47k; R1608
R10: 2.2k; R1608
RBOT: 3k; R1608
RPLP: 10k; R1608
RTOP: 8k; R1608
SW1: SLE6A4; SLE6_10A4
U1: MCP1700T-33; SOT23-3
U2: ADR5041; SC70-3
U4, U7, U8: TLP185(GR,E(O; SOP254P700X220-4N

Connections:
+3V3: C11.1, C16.1, C17.1, C18.1, D2.A, U1.2 (VO); also elsewhere on the board
+5V: C10.1, C13.1, COUT1.1, COUT2.1, D2.K, L2.2, LED1.A, R8.2, RPLP.1, RTOP.1, U1.3 (VI); also elsewhere on the board
GND: C7.N, C8.N, C9.N, C10.2, C11.2, C13.2, C16.2, C17.2, C18.2, C19.2, C20.2, CBP1.2, CBP2.2, CN1.N, CN5.N, CN6.N, COUT1.2, COUT2.2, COUT3.2, COUT4.2, COUT5.2, D4.A, D5.2 (A), IC2.4 (GND), IC2.14 (PGND_1), IC2.16 (VSW_4), Q1.2 (S), Q2.2 (S), Q3.2 (S), R2.2, R3.2, R5.2, R6.2, R10.1, R11.2, R13.1, R14.2, RBOT.2, U1.1 (GND), U2.2 (A); also elsewhere on the board
KICKER: CN6.P, F2.2
LSW1: U4.1 (ANODE); also elsewhere on the board
LSW2: U7.1 (ANODE); also elsewhere on the board
LSW3: U8.1 (ANODE); also elsewhere on the board
unnamed: CN2.N, Q1.3 (D)
unnamed: R1.2, U4.3 (EMITTER)
unnamed: COUT5.1, Q1.1 (G), R1.1, R2.1
unnamed: CN3.N, Q2.3 (D)
unnamed: R3.1, U4.2 (CATHODE)
unnamed: R6.1, U7.2 (CATHODE)
unnamed: R4.1, U7.3 (EMITTER)
unnamed: CN4.N, Q3.3 (D)
unnamed: CN1.P, SW1.1 (B)
unnamed: CBST.1, D5.1 (K), IC2.1 (VSW_1), IC2.12 (VSW_2), IC2.13 (VSW_3), IC2.17 (PAD), L2.1
unnamed: COUT3.1, Q2.1 (G), R4.2, R5.1
unnamed: LED1.K, R13.2
unnamed: IC2.5 (FB), RBOT.1
unnamed: IC2.8 (PG), RPLP.2, RTOP.2
unnamed: CBST.2, IC2.10 (BST)
unnamed: R14.1, U8.2 (CATHODE)
unnamed: R7.1, U8.3 (EMITTER)
unnamed: COUT4.1, Q3.1 (G), R7.2, R11.1
V+: C7.P, C8.P, C9.P, C19.1, C20.1, CBP1.1, CBP2.1, D4.K, F1.1, F2.1, IC2.2 (VCC_1), IC2.3 (VCC_2), IC2.11 (VCC_3), R9.2, SW1.P (A)
VMOTOR: CN2.P, CN3.P, CN4.P, CN5.P, F1.2, U4.4 (COLLECTOR), U7.4 (COLLECTOR), U8.4 (COLLECTOR)
VOLT_BAT: R9.1, R10.2; also elsewhere on the board
VREF: R8.1, U2.1 (K); also elsewhere on the board

Notes on the sheet:
EMVY630ARA221MKE0S
VOLT_BAT=0.72[V]@16[V] VOLT_BAT=1.07[V]@24[V] VOLT_BAT=2.24[V]@50[V]
V+_min = 4.5[V] V+_max = 40[V]

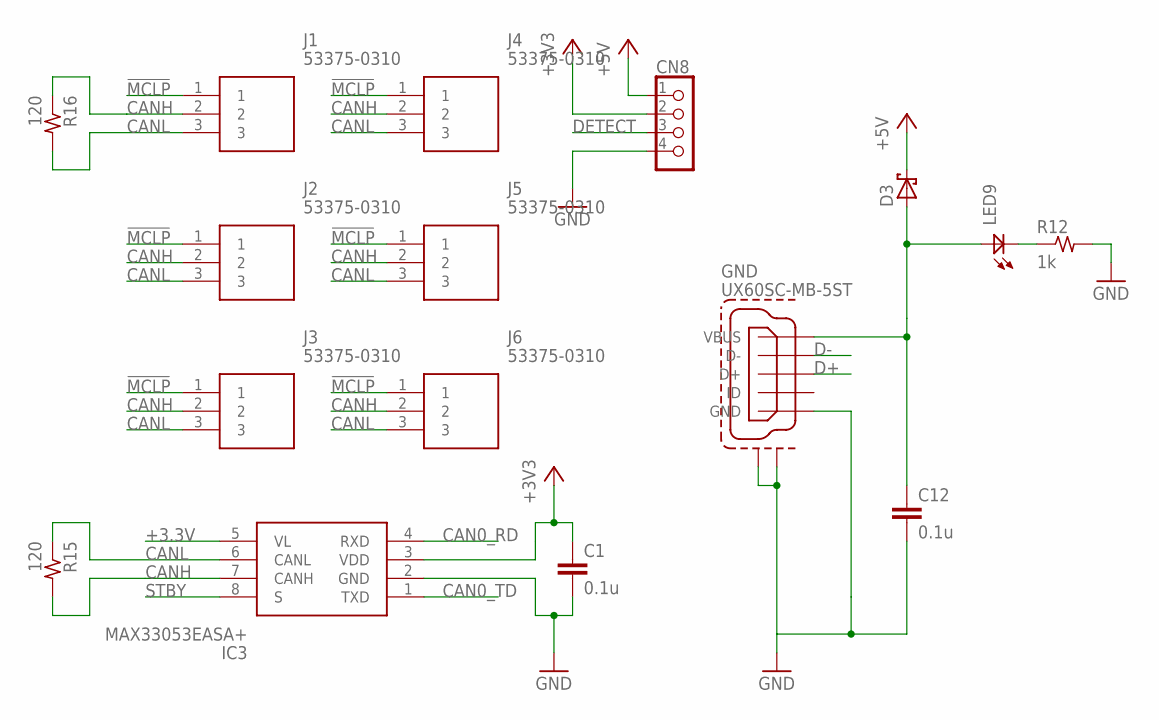
[picture p14: schematic MainBoard.sch, sheet 3, <b>Conectivity</b>]

Parts:
C1, C12: 0.1u; C1608
CN8: 53375-0410; 53375-04
D3: SBD-1608; 1608
GND: UX60SC-MB-5ST
IC3: MAX33053EASA+; SOIC127P605X145-8N
J1, J2, J3, J4, J5, J6: 53375-0310
LED9: LED1608
R12: 1k; R1608
R15, R16: 120; R1608

Connections:
!MCLP: J1.1, J2.1, J3.1, J4.1, J5.1, J6.1; also elsewhere on the board
+3.3V: IC3.5 (VL)
+3V3: CN8.2; also elsewhere on the board
+5V: CN8.1, D3.K; also elsewhere on the board
CAN0_RD: IC3.4 (RXD); also elsewhere on the board
CAN0_TD: IC3.1 (TXD); also elsewhere on the board
CANH: IC3.7 (CANH), J1.2, J2.2, J3.2, J4.2, J5.2, J6.2, R15.2, R16.1
CANL: IC3.6 (CANL), J1.3, J2.3, J3.3, J4.3, J5.3, J6.3, R15.1, R16.2
D+: GND.3 (D+); also elsewhere on the board
D-: GND.2 (D-); also elsewhere on the board
DETECT: CN8.3; also elsewhere on the board
GND: C1.2, C12.2, CN8.4, GND.5 (GND), GND.S1, GND.S2, IC3.2 (GND), R12.2; also elsewhere on the board
unnamed: C12.1, D3.A, GND.1 (VBUS), LED9.A
unnamed: LED9.K, R12.1
unnamed: C1.1, IC3.3 (VDD)
STBY: IC3.8 (S); also elsewhere on the board

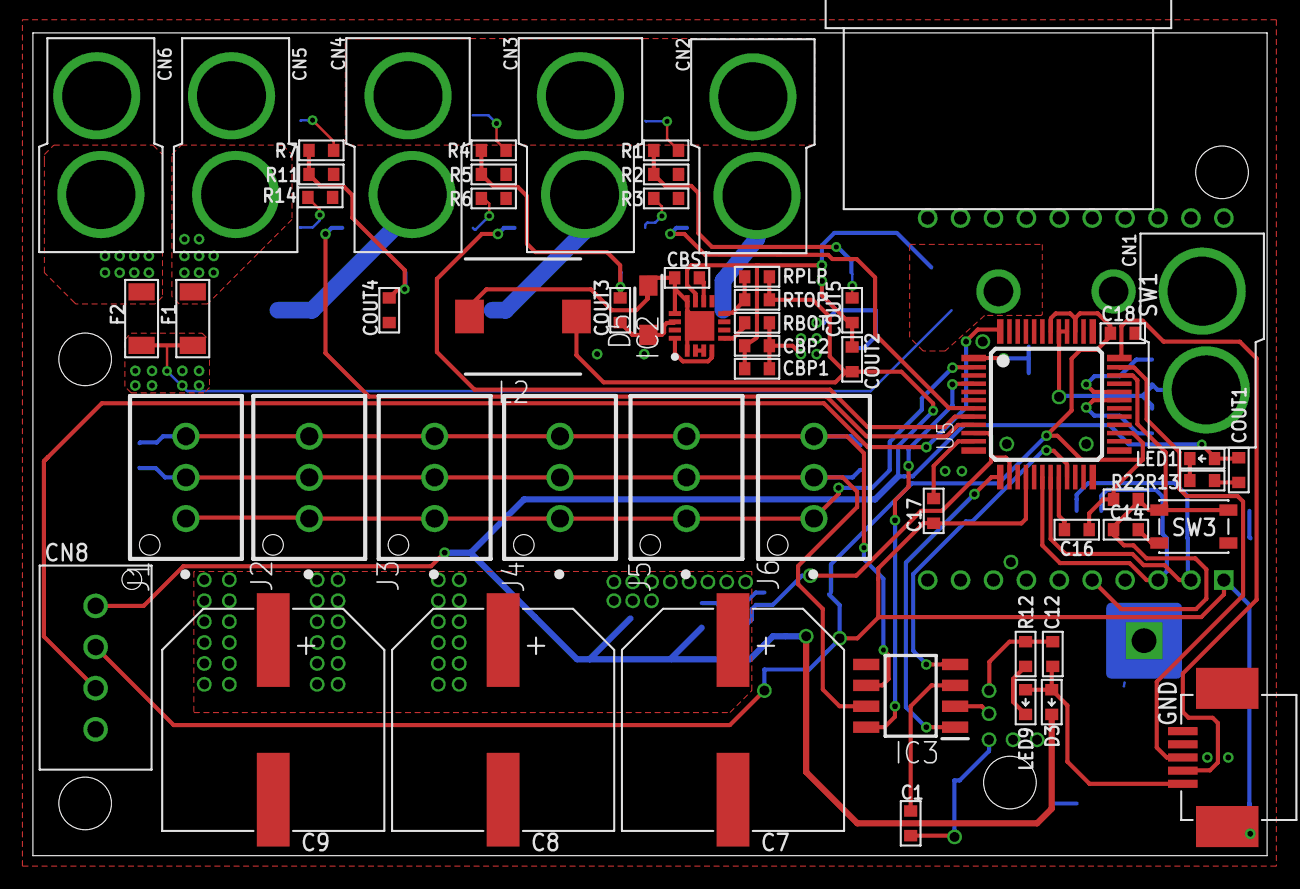
[picture p15: board MainBoard.brd from above]

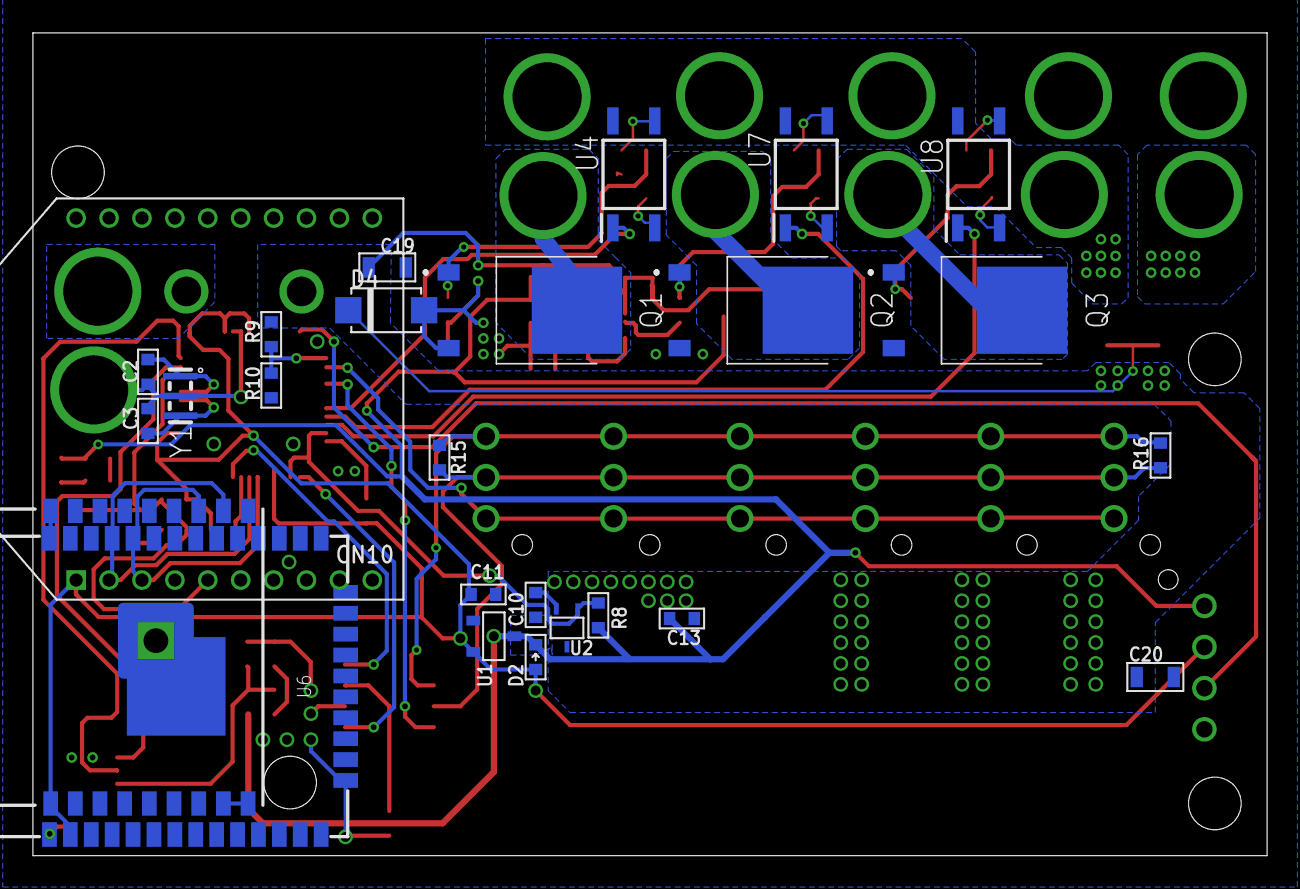
[picture p16: board MainBoard.brd from below]

Board: 2 copper layers, 75.0 x 50.0 mm, 84 parts (26 on the bottom side), 46 nets.
