Cocoas-Lab/Robocup-SSL-Circuit/(commit log)

2017-10-03 Design circuit to drive motor.
    [MotorDriver.brd, MotorDriver.ods, MotorDriver.sch]
2017-10-28 .epfの追跡をやめた
2017-10-28 KickerBoardの設計
    KIKSとの相違点
    ・動作電圧が50[V]まで
    ・LPCマイコン
    ・SPI接続
    ・充電電流の増加
    ・Fuse切断検出
    [KickerBoard.brd, KickerBoard.sch]
2017-10-28 電源監視部分のLPF遮断周波数を下げた
    [KickerBoard.brd, KickerBoard.sch]
2017-10-28 Descriptionを記述
2017-10-28 .gitignoreの編集
2017-10-28 とりあえず基板の形にしてみた
    [Controller.ods, MainBoard.brd, MainBoard.sch]
2017-10-28 '*_sch.pdf' と '*_brd.pdf' を無視するように
2017-10-28 ライブラリ用のリポジトリ
2017-10-28 Desctiptionの編集
2017-11-02 KickerBoardの部品表作成(途中)
    [Kicker.ods, KickerBoard.brd, KickerBoard.sch]
2017-11-05 SCT1_OUT[5, 6]を使うために配線を入れ替えた
    1: PWM_CL->MOSI
    2: PWM_CH->RX
    22: RX->PWM_CH
    33 MOSI->PWM_CL
    [MotorDriver.brd, MotorDriver.sch]
2017-11-11 FETのゲートソース間に抵抗を追加
    [MotorDriver.brd, MotorDriver.sch]
2017-11-11 部品表を更新
    [MotorDriver.ods]
2017-11-11 なんで.epfないん？
2017-11-11 なぜ私は.epfを日追跡にしてしまったの？
2018-01-02 無視リストを編集
    * `*.stp` と `*.lbr` は追跡しない
2018-01-02 機能追加 *CANバス *ホールセンサをダイレクトでDRVへ入力 *電源電圧監視 *DCDCをGDに内蔵 *15Aヒューズ
    機能削減
    *UART-DFUを廃止
    *SPI接続を廃止
    [MotorDriver.brd, MotorDriver.sch]
2018-01-03 ヒューズ切断検出機能を追加
    [MotorDriver.brd, MotorDriver.sch]
2018-01-23 USBラインの保護を強化した
    [MotorDriver.brd, MotorDriver.sch]
2018-02-28 [fix]電源補助コンデンサの容量を小さくした
    [MotorDriver.brd, MotorDriver.sch]
2018-02-28 [del]プルアップ/ダウン抵抗を除去
    *プルアップ/ダウンにはマイコンの機能を使用することにした
    [MotorDriver.brd, MotorDriver.sch]
2018-03-01 メインとの通信をSPIからCANに切り替えた
    [KickerBoard.brd, KickerBoard.sch]
2018-03-01 書き込み部・電源部を変更
    *書き込みをUARTからUSBに変更
    *USBコネクタを追加
    *12[MHz]クロックを追加
    *保護ICを追加
    *ピンヘッダを削除
    *5[V]電源の削除
    *5[V]を使用している箇所がなかったので無くした
    *レギュレータを5[V]->3.3[V]から12[V]->3.3[V]に
    *USBのVBUSはレギュレータのみに入る
    *VBUS, 12[V]へ逆流防止ダイオードを追加
    [KickerBoard.brd, KickerBoard.sch]
2018-03-02 .epfが書き換わっていたので
2018-03-08 viaの数とかを調節した
    [KickerBoard.brd, KickerBoard.sch]
2018-03-08 デバイス側で`id`を使ってUSBの接続を検出するのは不可能なので保護ICの`!ack`を使うように変更
    [MotorDriver.brd, MotorDriver.sch]
2018-05-20 [fix]USB-ACKのプルアップ抵抗の変更とコメントの整理
    [MotorDriver.brd, MotorDriver.sch]
2018-05-21 [fix] Kickerのコネクタのアサインを変更
    [KickerBoard.brd, KickerBoard.sch]
2018-07-13 [add] schのpdfを追加
2018-07-13 [fix]DESCRIPTIONの編集
2018-07-31 [fix]仕様確定に伴って変更
    *電源電圧を24[V]に
    *エンコーダICが廃盤になったので変更
    *電源強化
    *部品票の更新
    [MotorDriver.brd, MotorDriver.ods, MotorDriver.sch]
2018-07-31 [fix]部品表がいろいろおかしい
    [MotorDriver.ods]
2018-08-19 [fix]キッカーボードを25[V]仕様に変更(部品表はまだ)
    [KickerBoard.brd, KickerBoard.sch]
2018-08-19 [fix]pdfの更新
2018-08-19 これでコンフリクト回避できるかな
2018-09-09 [fix]ファイルが壊れてた
    [KickerBoard.brd, KickerBoard.sch]
2019-12-03 tmpからもってきた
    [DRILEGEND.CFG, Kicker.ods, KickerBoard.brd, KickerBoard.csv, KickerBoard.sch, MainBoard.brd, MainBoard.sch, MotorDriver.brd]
