Cocoas-Lab/Robocup-SSL-Circuit/(notices)

Notices in the files:
parts and their libraries:
NXP_60_26022015: This library may be distributed and adapted freely for any purpose, as long as NXP is credited and any new creation is licensed under the same terms.
